PyCubed-Mini/avionics-mainboard/README.md

# avionics-motherboard
Main flight computer board for the PyCubed-Mini spacecraft
