PyCubed-Mini/avionics-mainboard/(threads)

Thread 1 (2022-02-22):

Replace camera FFC with 1.27mm stacking header

jbwillis, 2022-02-22:
Connection between camera and mainboard will be a 2x5 1.27mm stacking header [](https://www.digikey.com/en/products/detail/amphenol-icc-fci/20021121-00010C1LF/4243096)

- [x] Update footprint on Camera board
- [x] Update footprint on main board
- [x] ensure algnment between camera and main board is sufficient.
- [x] update 3D model to match board-board spacing between mainboard and camera board

Closed 2022-03-16.

Thread 2 (2022-02-22):

Load firmware onto current mainboard rev and run tests

jbwillis, 2022-02-22:
Follow instructions in `firmware` directory for loading firmware onto mainboard.

- [x] To power via USB, a jumper needs to be added to the RBF pin header.
- [x] Load firmware
- [x] See what tests already exist and run them. Ideas include I2C sniffer, neopixel flashing, reading IMU, connecting solar boards and reading sun sensor and solar controller data.

thetazero, 2022-02-23:
[Link](https://github.com/spacecraft-design-lab-2019/avionics-motherboard/tree/zac-updates/firmware) to said firmware directory for reference:

thetazero, 2022-02-24:
Updated the boards, and added instructions for how to do so [here](https://github.com/PyCubed-Mini/NewDocumentation/wiki/Circuit-Python#updating-the-pycubedmini-board).
Not sure how to connect the solar boards, that should probably be our next task.

Closed 2022-05-12.

Thread 4 (2022-02-23):

Change RBF pin to 1x6 header

jbwillis, 2022-02-23:
To allow space for the camera USB connector to be access through the Z board, change the RBF pin to a 1x6 header, and leave either pin 3 or 4 as no connect. We will fill the corresponding hole in the header with glue and cut the corresponding pin. This will act as a "key" to prevent accidental incorrect insertion.

Closed 2022-03-16.

Thread 8 (2022-06-02):

Test Burnwire circuit with PWM gate control, and switch BURN1 to a MCU pin with PWM support

NeilKhera, 2022-06-02:

Closed 2022-06-13.

Thread 9 (2022-06-13):

I2C 3 to solar boards

jbwillis, 2022-06-13:
Send I2C 3 to two solar boards to keep two boards per bus. This will allow us to use a different (easier to find) light sensor

Closed 2022-09-06.

Thread 11 (2022-07-06):

Reset button accessible from outside satellite

jbwillis, 2022-07-06:
To allow firmware updates without dissassembling, we need to make the reset button accessible from outside the satellite body.

My thought for how to do this is to put a right angle tactile switch on the mainboard and then have a small hole that a paperclip-wide pin can be pressed through to depress the switch.

NeilKhera, 2022-12-01:
Select a different right-angle reset button. The current one is kinda fragile

Closed 2023-03-16.

Thread 12 (2022-07-06):

Find new motor drivers

jbwillis, 2022-07-06:
Find new motor (magnetorquer) drivers, ideally ones that can be actuated via I2C.

Can separate the drivers onto different I2C busses, so same address won't be an issue.

NeilKhera, 2022-08-31:
No longer necessary since sufficient quantities of existing motor drivers were purchased.

Thread 15 (2022-08-03):

Replace X/Z solar connectors with CLP-105-02-F-DH-A

jbwillis, 2022-08-03:
should be easier to solder, plus they are mechanically compatible with the SFMH connectors currently on the mainboard, so no changes to the solar boards will be necessary.

Closed 2022-09-06.

Thread 17 (2022-08-12):

Change resistor divider to HI_POW rather than BATT_P

jbwillis, 2022-08-12:
To allow for testing with USB connected and the power select switch on VUSB, we need the mcu to measure the VUSB voltage rather than BATT_P.

Thread 18 (2022-08-12):

Add Real Time Clock

jbwillis, 2022-08-12:
A real time clock would enable us to keep track of time even when the mcu is off.
I don't believe we can have it powered during launch, so we will need to power it from the batteries (no separate battery for it).

Check the full PyCubed design to see if Max has already selected a RTC.

Closed 2022-09-06.

Thread 22 (2022-09-21):

Payload Interface

jbwillis, 2022-09-21:
- [x] Move SD card onto mainboard
- [ ] Remove all I2C bus protection circuits on mainboard
- [x] Route UART and 3V3 to Payload Board
- [x] Consider payload power enable to allow us to turn it on/off

Closed 2022-12-01.

Thread 26 (2022-12-01):

Add USB LiPo Charge Circuit?

NeilKhera, 2022-12-01:
Could be useful. The full-sized PyCubed board has this

jbwillis, 2022-12-01:
Yeah this could be nice. There are reasons not to though. Mostly so we can monitor the satellite without changing its power state.

Thread 28 (2023-01-13):

reduce board corners by 0.1mm on each side

jbwillis, 2023-01-13:
slight reduction in board outline (could even be less) to  avoid assembly interference.

Closed 2023-03-16.

Thread 30 (2023-03-26):

Connect IMU INT and RST lines to MCU

NeilKhera, 2023-03-26:
May be required for stable SPI operation. Further tests necessary

NeilKhera, 2023-04-26:
Fixed in Rev B3/02

Closed 2023-04-26.

Thread 33 (2023-04-26):

Replace reset button (again)

NeilKhera, 2023-04-26:

NeilKhera, 2023-04-26:
Replaced with Wurth 434331045822 in Rev B3/02

Closed 2023-04-26.
