PyCubed-Mini/avionics-mainboard/mainboard.kicad_pcb

## KiCad design mainboard.kicad_pcb (2023-06-20)

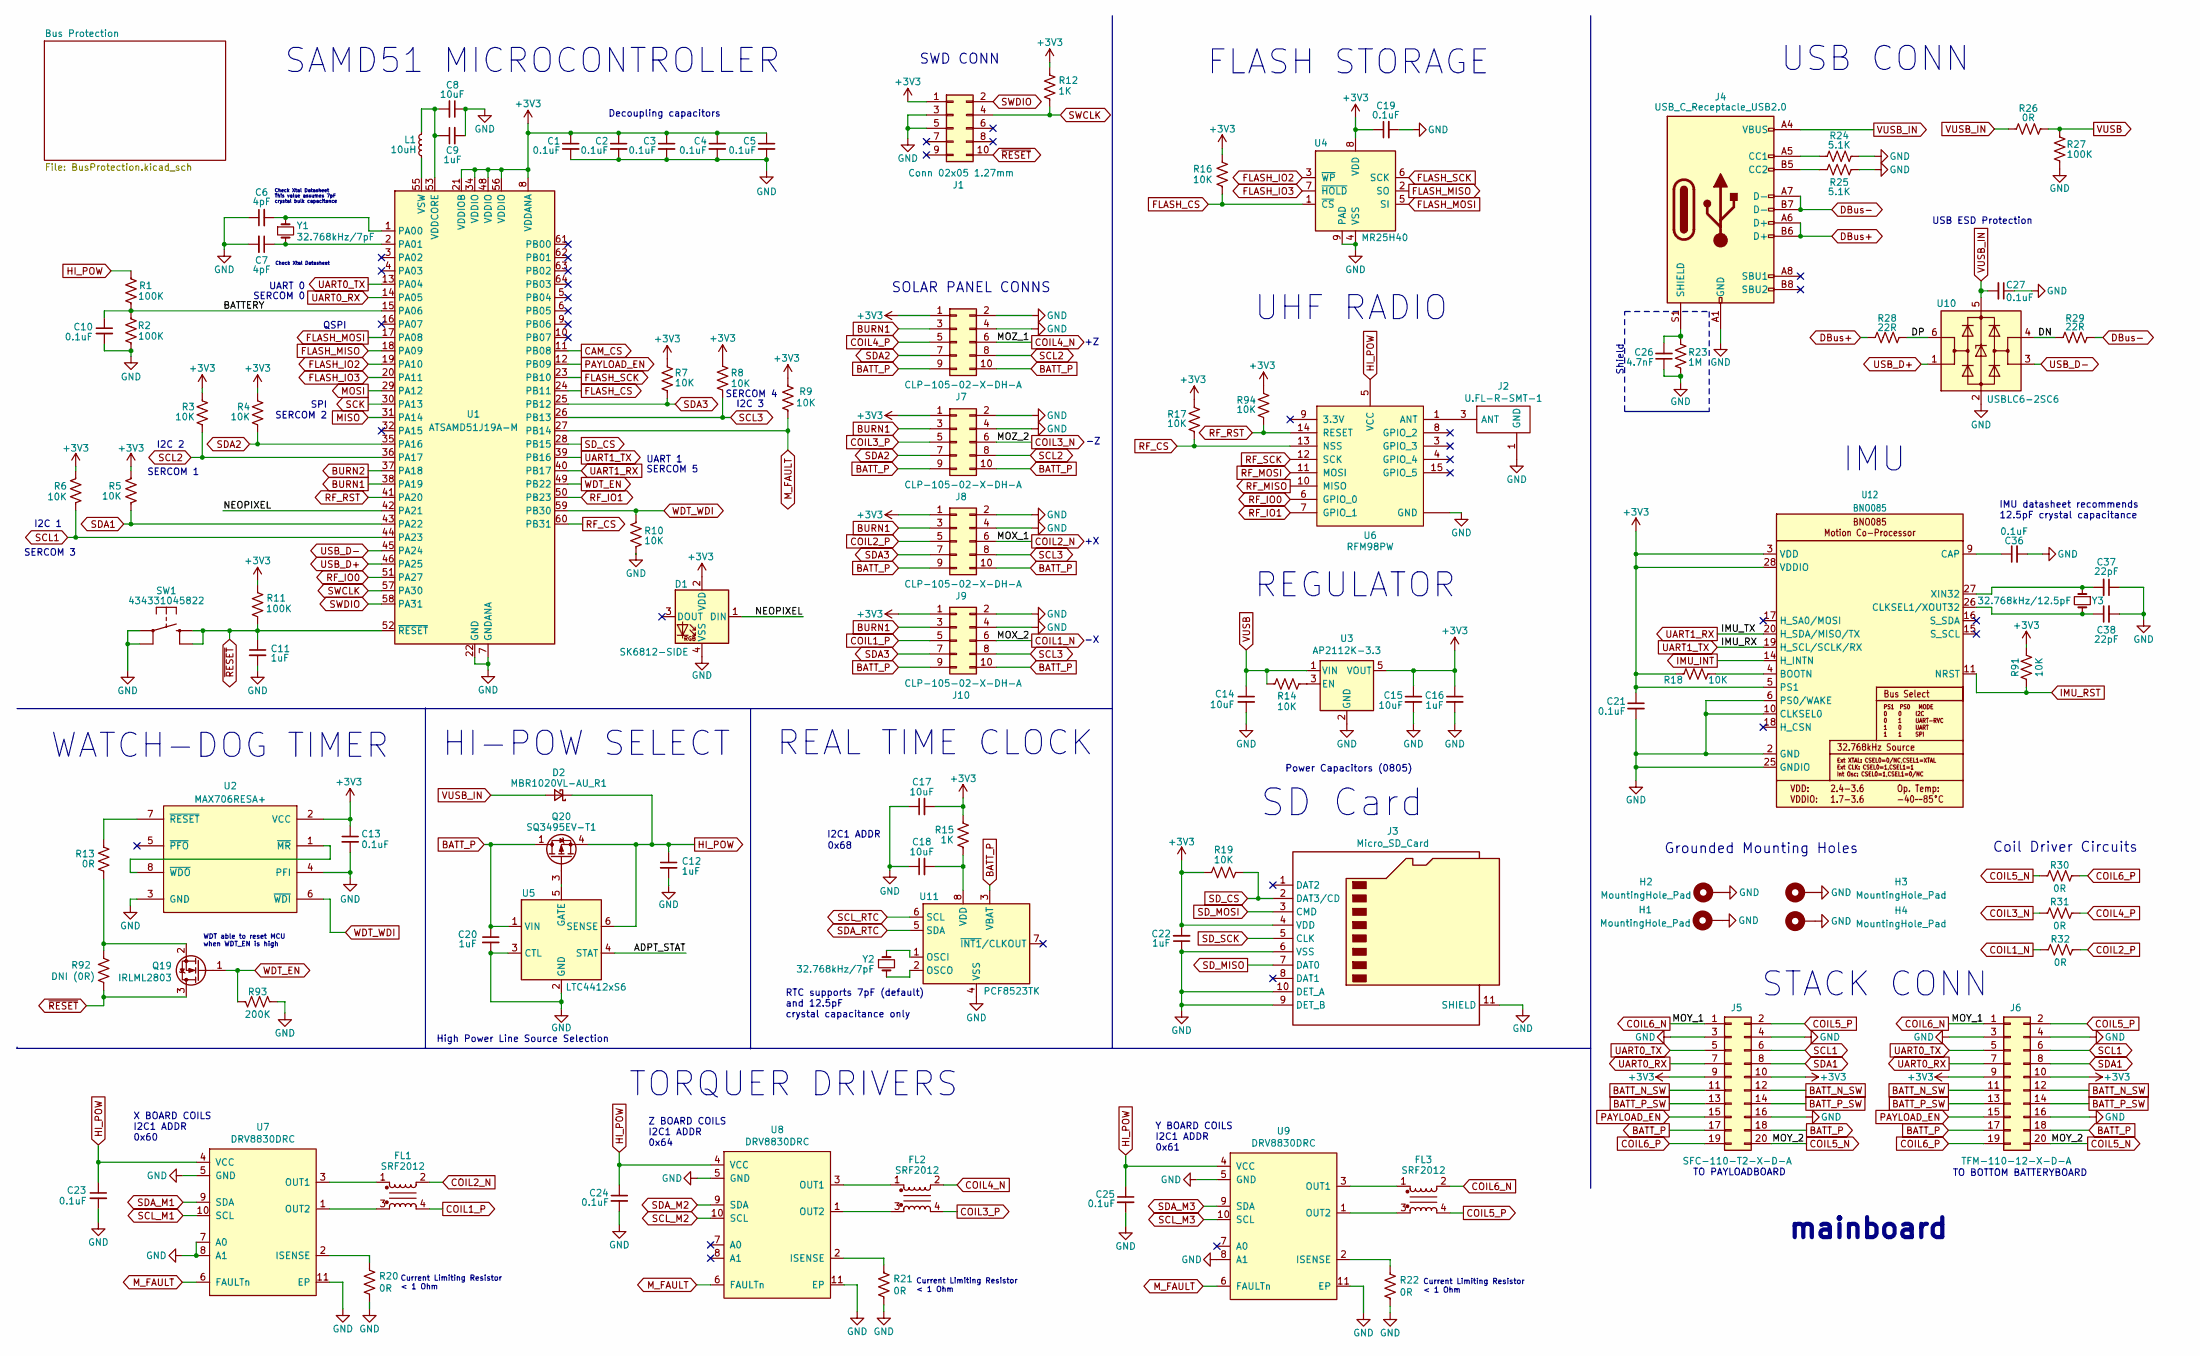
[picture p1: schematic mainboard.kicad_sch, PyCubed Mini]

Parts:
C1, C2, C3, C4, C5, C10, C13, C19, C21, C23, C24, C25, C27, C36: 0.1uF; C_0603_1608Metric
C6, C7: 4pF; C_0603_1608Metric
C8, C17, C18: 10uF; C_0603_1608Metric
C9, C11, C12, C20, C22: 1uF; C_0603_1608Metric
C14, C15: 10uF; C_0805_2012Metric
C16: 1uF; C_0805_2012Metric
C26: 4.7nF; C_0603_1608Metric
C37, C38: 22pF; C_0603_1608Metric
D1: SK6812-SIDE
D2: MBR1020VL-AU_R1; D_SOD-123F
FL1, FL2, FL3: SRF2012
H1, H2, H3, H4: MountingHole_Pad; MountingHole
J1: Conn 02x05 1.27mm; PinHeader_2x05_P1.27mm_Vertical_SMD
J2: U.FL-R-SMT-1; Manufacturer_Part_Number U.FL-R-SMT-1
J3: Micro_SD_Card; microSD_104031-0811
J4: USB_C_Receptacle_USB2.0; USB_C_Receptacle_HRO_TYPE-C-31-M-12
J5: SFC-110-T2-X-D-A; SAMTEC_SFC-110-T2-X-D-A
J6: TFM-110-12-X-D-A; SAMTEC_TFM-110-12-X-D-A
J7, J8, J9, J10: CLP-105-02-X-DH-A; SAMTEC_CLP-105-02-X-DH-A
L1: 10uH; L_0805_2012Metric
Q19: IRLML2803; SOT-23
Q20: SQ3495EV-T1; SOT-23-6
R1, R2, R11, R27: 100K; R_0603_1608Metric
R3, R4, R5, R6, R7, R8, R9, R10, R14, R16, R17, R18, R19, R91, R94: 10K; R_0603_1608Metric
R12, R15: 1K; R_0603_1608Metric
R13, R20, R21, R22, R26, R30, R31, R32: 0R; R_0603_1608Metric
R23: 1M; R_0603_1608Metric
R24, R25: 5.1K; R_0603_1608Metric
R28, R29: 22R; R_0603_1608Metric
R92: DNI (0R); R_0603_1608Metric
R93: 200K; R_0603_1608Metric
SW1: 434331045822; SMT_1045822_WRE
U1: ATSAMD51J19A-M; QFN-64-1EP_9x9mm_P0.5mm_EP4.7x4.7mm
U2: MAX706RESA+; SOIC-8_3.9x4.9mm_P1.27mm
U3: AP2112K-3.3; SOT-23-5
U4: MR25H40; MR25H40DF
U5: LTC4412xS6; TSOT-23-6
U6: RFM98PW
U7, U8, U9: DRV8830DRC; VSON-10
U10: USBLC6-2SC6; SOT-23-6
U11: PCF8523TK; HVSON-8-1EP_4x4mm_P0.8mm_EP2.2x3.1mm
U12: BNO085
Y1, Y2: 32.768kHz/7pF; Crystal_SMD_MicroCrystal_CC7V-T1A-2Pin_3.2x1.5mm
Y3: 32.768kHz/12.5pF; Crystal_SMD_MicroCrystal_CC7V-T1A-2Pin_3.2x1.5mm

Connections:
+3V3: C1.1, C2.1, C3.1, C4.1, C5.1, C13.1, C15.1, C16.1, C17.2, C19.1, C21.1, C22.2, D1.2 (VDD), J1.1, J3.4 (VDD), J5.9, J5.10, J6.9, J6.10, J7.1, J8.1, J9.1, J10.1, R3.2, R4.2, R5.2, R6.2, R7.2, R8.2, R9.1, R11.2, R12.2, R15.2, R16.1, R17.2, R18.2, R19.1, R91.2, R94.2, U1.8 (VDDANA), U1.21 (VDDIOB), U1.34 (VDDIO), U1.48 (VDDIO), U1.56 (VDDIO), U2.2 (VCC), U3.5 (VOUT), U4.8 (VDD), U12.3 (VDD), U12.5 (PS1), U12.28 (VDDIO); also elsewhere on the board
/ADPT_STAT: U5.4 (STAT)
/BATTERY: C10.1, R1.1, R2.2, U1.15 (PA06)
/DN: R29.2, U10.4 (I/O2)
/DP: R28.1, U10.6 (I/O1)
/NEOPIXEL: D1.1 (DIN), U1.42 (PA21)
BATT_N_SW: J5.11, J5.12, J6.11, J6.12
BATT_P: C20.1, J5.17, J5.18, J6.17, J6.18, J7.9, J7.10, J8.9, J8.10, J9.9, J9.10, J10.9, J10.10, Q20.1 (D), Q20.2 (D), Q20.5 (D), Q20.6 (D), U5.1 (VIN), U11.3 (VBAT)
BATT_P_SW: J5.13, J5.14, J6.13, J6.14
BURN1: J7.3, J8.3, J9.3, J10.3, U1.38 (PA19)
BURN2: U1.37 (PA18)
CAM_CS: U1.11 (PB08)
COIL1_N: J10.6, R32.1
COIL1_P: FL1.4, J10.5
COIL2_N: FL1.2, J9.6
COIL2_P: J9.5, R32.2
COIL3_N: J8.6, R31.1
COIL3_P: FL2.4, J8.5
COIL4_N: FL2.2, J7.6
COIL4_P: J7.5, R31.2
COIL5_N: J5.20, J6.20, R30.2
COIL5_P: FL3.4, J5.2, J6.2
COIL6_N: FL3.2, J5.1, J6.1
COIL6_P: J5.19, J6.19, R30.1
DBus+: J4.A6 (D+), J4.B6 (D+), R28.2
DBus-: J4.A7 (D-), J4.B7 (D-), R29.1
FLASH_CS: R16.2, U1.24 (PB11), U4.1 (~CS)
FLASH_IO2: U1.19 (PA10), U4.3 (~WP)
FLASH_IO3: U1.20 (PA11), U4.7 (~HOLD)
FLASH_MISO: U1.18 (PA09), U4.2 (SO)
FLASH_MOSI: U1.17 (PA08), U4.5 (SI)
FLASH_SCK: U1.23 (PB10), U4.6 (SCK)
GND: C1.2, C2.2, C3.2, C4.2, C5.2, C6.1, C7.2, C8.1, C9.2, C10.2, C11.2, C12.2, C13.2, C14.2, C15.2, C16.2, C17.1, C18.1, C19.2, C20.2, C21.2, C22.1, C23.2, C24.2, C25.2, C26.1, C27.1, C36.2, C37.1, C38.2, D1.4 (VSS), H1.1, H2.1, H3.1, H4.1, J1.3, J1.5, J2.1 (GND), J2.2, J3.6 (VSS), J3.9 (DET_B), J3.10 (DET_A), J3.11 (SHIELD), J4.A1 (GND), J4.A12 (GND), J4.B1 (GND), J4.B12 (GND), J5.3, J5.4, J5.16, J6.3, J6.4, J6.16, J7.2, J7.4, J8.2, J8.4, J9.2, J9.4, J10.2, J10.4, R2.1, R10.1, R20.1, R21.1, R22.1, R23.1, R24.2, R25.2, R27.2, R93.2, SW1.1, SW1.3 (P1), U1.7 (GNDANA), U1.22 (GND), U1.33 (GND), U1.47 (GND), U1.54 (GND), U1.65 (GND), U2.3 (GND), U2.4 (PFI), U3.2 (GND), U4.4 (VSS), U4.9 (PAD), U5.2 (GND), U5.3 (CTL), U6.2 (GND), U6.16 (GND), U6.17 (GND), U7.5 (GND), U7.7 (A0), U7.8 (A1), U7.11 (EP), U8.5 (GND), U8.11 (EP), U9.5 (GND), U9.8 (A1), U9.11 (EP), U10.2 (GND), U11.4 (VSS), U11.9 (VSS), U12.2 (GND), U12.6 (PS0/WAKE), U12.10 (CLKSEL0), U12.25 (GNDIO); also elsewhere on the board
HI_POW: C12.1, C23.1, C24.1, C25.1, D2.1 (K), Q20.4 (S), R1.2, U5.6 (SENSE), U6.5 (VCC), U7.4 (VCC), U8.4 (VCC), U9.4 (VCC)
IMU_INT: U12.14 (H_INTN)
IMU_RST: R91.1, U12.11 (NRST)
MISO: U1.31 (PA14); also elsewhere on the board
MOSI: U1.29 (PA12); also elsewhere on the board
M_FAULT: R9.2, U1.27 (PB14), U7.6 (FAULTn), U8.6 (FAULTn), U9.6 (FAULTn)
unnamed: J2.3 (ANT), U6.1 (ANT)
unnamed: J4.A5 (CC1), R24.1
unnamed: J4.B5 (CC2), R25.1
unnamed: C26.2, J4.S1 (SHIELD), R23.2
unnamed: Q19.2 (S), R13.1, R92.2
unnamed: Q20.3 (G), U5.5 (GATE)
unnamed: C6.2, U1.1 (PA00), Y1.1
unnamed: C7.1, U1.2 (PA01), Y1.2
unnamed: C8.2, C9.1, L1.1, U1.53 (VDDCORE)
unnamed: L1.2, U1.55 (VSW)
unnamed: U2.1 (~MR), U2.8 (~WDO)
unnamed: R13.2, U2.7 (~RESET)
unnamed: R14.2, U3.3 (EN)
unnamed: R20.2, U7.2 (ISENSE)
unnamed: FL1.1, U7.3 (OUT1)
unnamed: FL1.3, U7.1 (OUT2)
unnamed: R21.2, U8.2 (ISENSE)
unnamed: FL2.1, U8.3 (OUT1)
unnamed: FL2.3, U8.1 (OUT2)
unnamed: R22.2, U9.2 (ISENSE)
unnamed: FL3.1, U9.3 (OUT1)
unnamed: FL3.3, U9.1 (OUT2)
unnamed: U11.1 (OSCI), Y2.1
unnamed: U11.2 (OSCO), Y2.2
unnamed: C18.2, R15.1, U11.8 (VDD)
unnamed: R18.1, U12.4 (BOOTN)
unnamed: C36.1, U12.9 (CAP)
unnamed: C38.1, U12.26 (CLKSEL1/XOUT32), Y3.2
unnamed: C37.2, U12.27 (XIN32), Y3.1
PAYLOAD_EN: J5.15, J6.15, U1.12 (PB09)
RF_CS: R17.1, U1.60 (PB31), U6.13 (NSS); also elsewhere on the board
RF_IO0: U1.51 (PA27), U6.6 (GPIO_0)
RF_IO1: U1.50 (PB23), U6.7 (GPIO_1)
RF_MISO: U6.10 (MISO); also elsewhere on the board
RF_MOSI: U6.11 (MOSI); also elsewhere on the board
RF_RST: R94.1, U1.41 (PA20), U6.14 (RESET)
RF_SCK: U6.12 (SCK); also elsewhere on the board
SCK: U1.30 (PA13); also elsewhere on the board
SCL1: J5.6, J6.6, R6.1, U1.44 (PA23); also elsewhere on the board
SCL2: J7.8, J8.8, R3.1, U1.36 (PA17)
SCL3: J9.8, J10.8, R8.1, U1.26 (PB13)
SCL_M1: U7.10 (SCL); also elsewhere on the board
SCL_M2: U8.10 (SCL); also elsewhere on the board
SCL_M3: U9.10 (SCL); also elsewhere on the board
SCL_RTC: U11.6 (SCL); also elsewhere on the board
SDA1: J5.8, J6.8, R5.1, U1.43 (PA22); also elsewhere on the board
SDA2: J7.7, J8.7, R4.1, U1.35 (PA16)
SDA3: J9.7, J10.7, R7.1, U1.25 (PB12)
SDA_M1: U7.9 (SDA); also elsewhere on the board
SDA_M2: U8.9 (SDA); also elsewhere on the board
SDA_M3: U9.9 (SDA); also elsewhere on the board
SDA_RTC: U11.5 (SDA); also elsewhere on the board
SD_CS: J3.2 (DAT3/CD), R19.2, U1.28 (PB15); also elsewhere on the board
SD_MISO: J3.7 (DAT0); also elsewhere on the board
SD_MOSI: J3.3 (CMD); also elsewhere on the board
SD_SCK: J3.5 (CLK); also elsewhere on the board
SWCLK: J1.4, R12.1, U1.57 (PA30)
SWDIO: J1.2, U1.58 (PA31)
UART0_RX: J5.7, J6.7, U1.14 (PA05)
UART0_TX: J5.5, J6.5, U1.13 (PA04)
UART1_RX: U1.40 (PB17), U12.20 (H_SDA/MISO/TX)
UART1_TX: U1.39 (PB16), U12.19 (H_SCL/SCLK/RX)
USB_D+: U1.46 (PA25), U10.1 (I/O1)
USB_D-: U1.45 (PA24), U10.3 (I/O2)
VUSB: C14.1, R14.1, R26.2, R27.1, U3.1 (VIN)
VUSB_IN: C27.2, D2.2 (A), J4.A4 (VBUS), J4.A9 (VBUS), J4.B4 (VBUS), J4.B9 (VBUS), R26.1, U10.5 (VBUS)
WDT_EN: Q19.1 (G), R93.1, U1.49 (PB22)
WDT_WDI: R10.2, U1.59 (PB30), U2.6 (~WDI)
~RESET: C11.1, J1.10, Q19.3 (D), R11.1, R92.1, SW1.2 (S), SW1.4 (S1), U1.52 (~RESET)

Notes on the sheet:
High Power Line Source Selection
X BOARD COILS I2C1 ADDR 0x60
SERCOM 0
WDT able to reset MCU when WDT_EN is high
Current Limiting Resistor < 1 Ohm
mainboard
0x68
SAMD51 MICROCONTROLLER
FLASH STORAGE
UART 1
USB ESD Protection
REGULATOR
UART 0
SOLAR PANEL CONNS
SPI
I2C 3
Check Xtal Datasheet
IMU datasheet recommends 12.5pF crystal capacitance
TO BOTTOM BATTERYBOARD
TORQUER DRIVERS
WATCH-DOG TIMER
SWD CONN
SERCOM 1
Coil Driver Circuits
STACK CONN
Shield
SERCOM 5
Decoupling capacitors
I2C 2
SERCOM 3
Z BOARD COILS I2C1 ADDR 0x64
IMU
UHF RADIO
SERCOM 2
Check Xtal Datasheet This value assumes 7pF crystal bulk capacitance
I2C 1
SERCOM 4
Grounded Mounting Holes
USB CONN
SD Card
HI-POW SELECT
REAL TIME CLOCK
Y BOARD COILS I2C1 ADDR 0x61
Power Capacitors (0805)
QSPI
TO PAYLOADBOARD
I2C1 ADDR
RTC supports 7pF (default) and 12.5pF crystal capacitance only

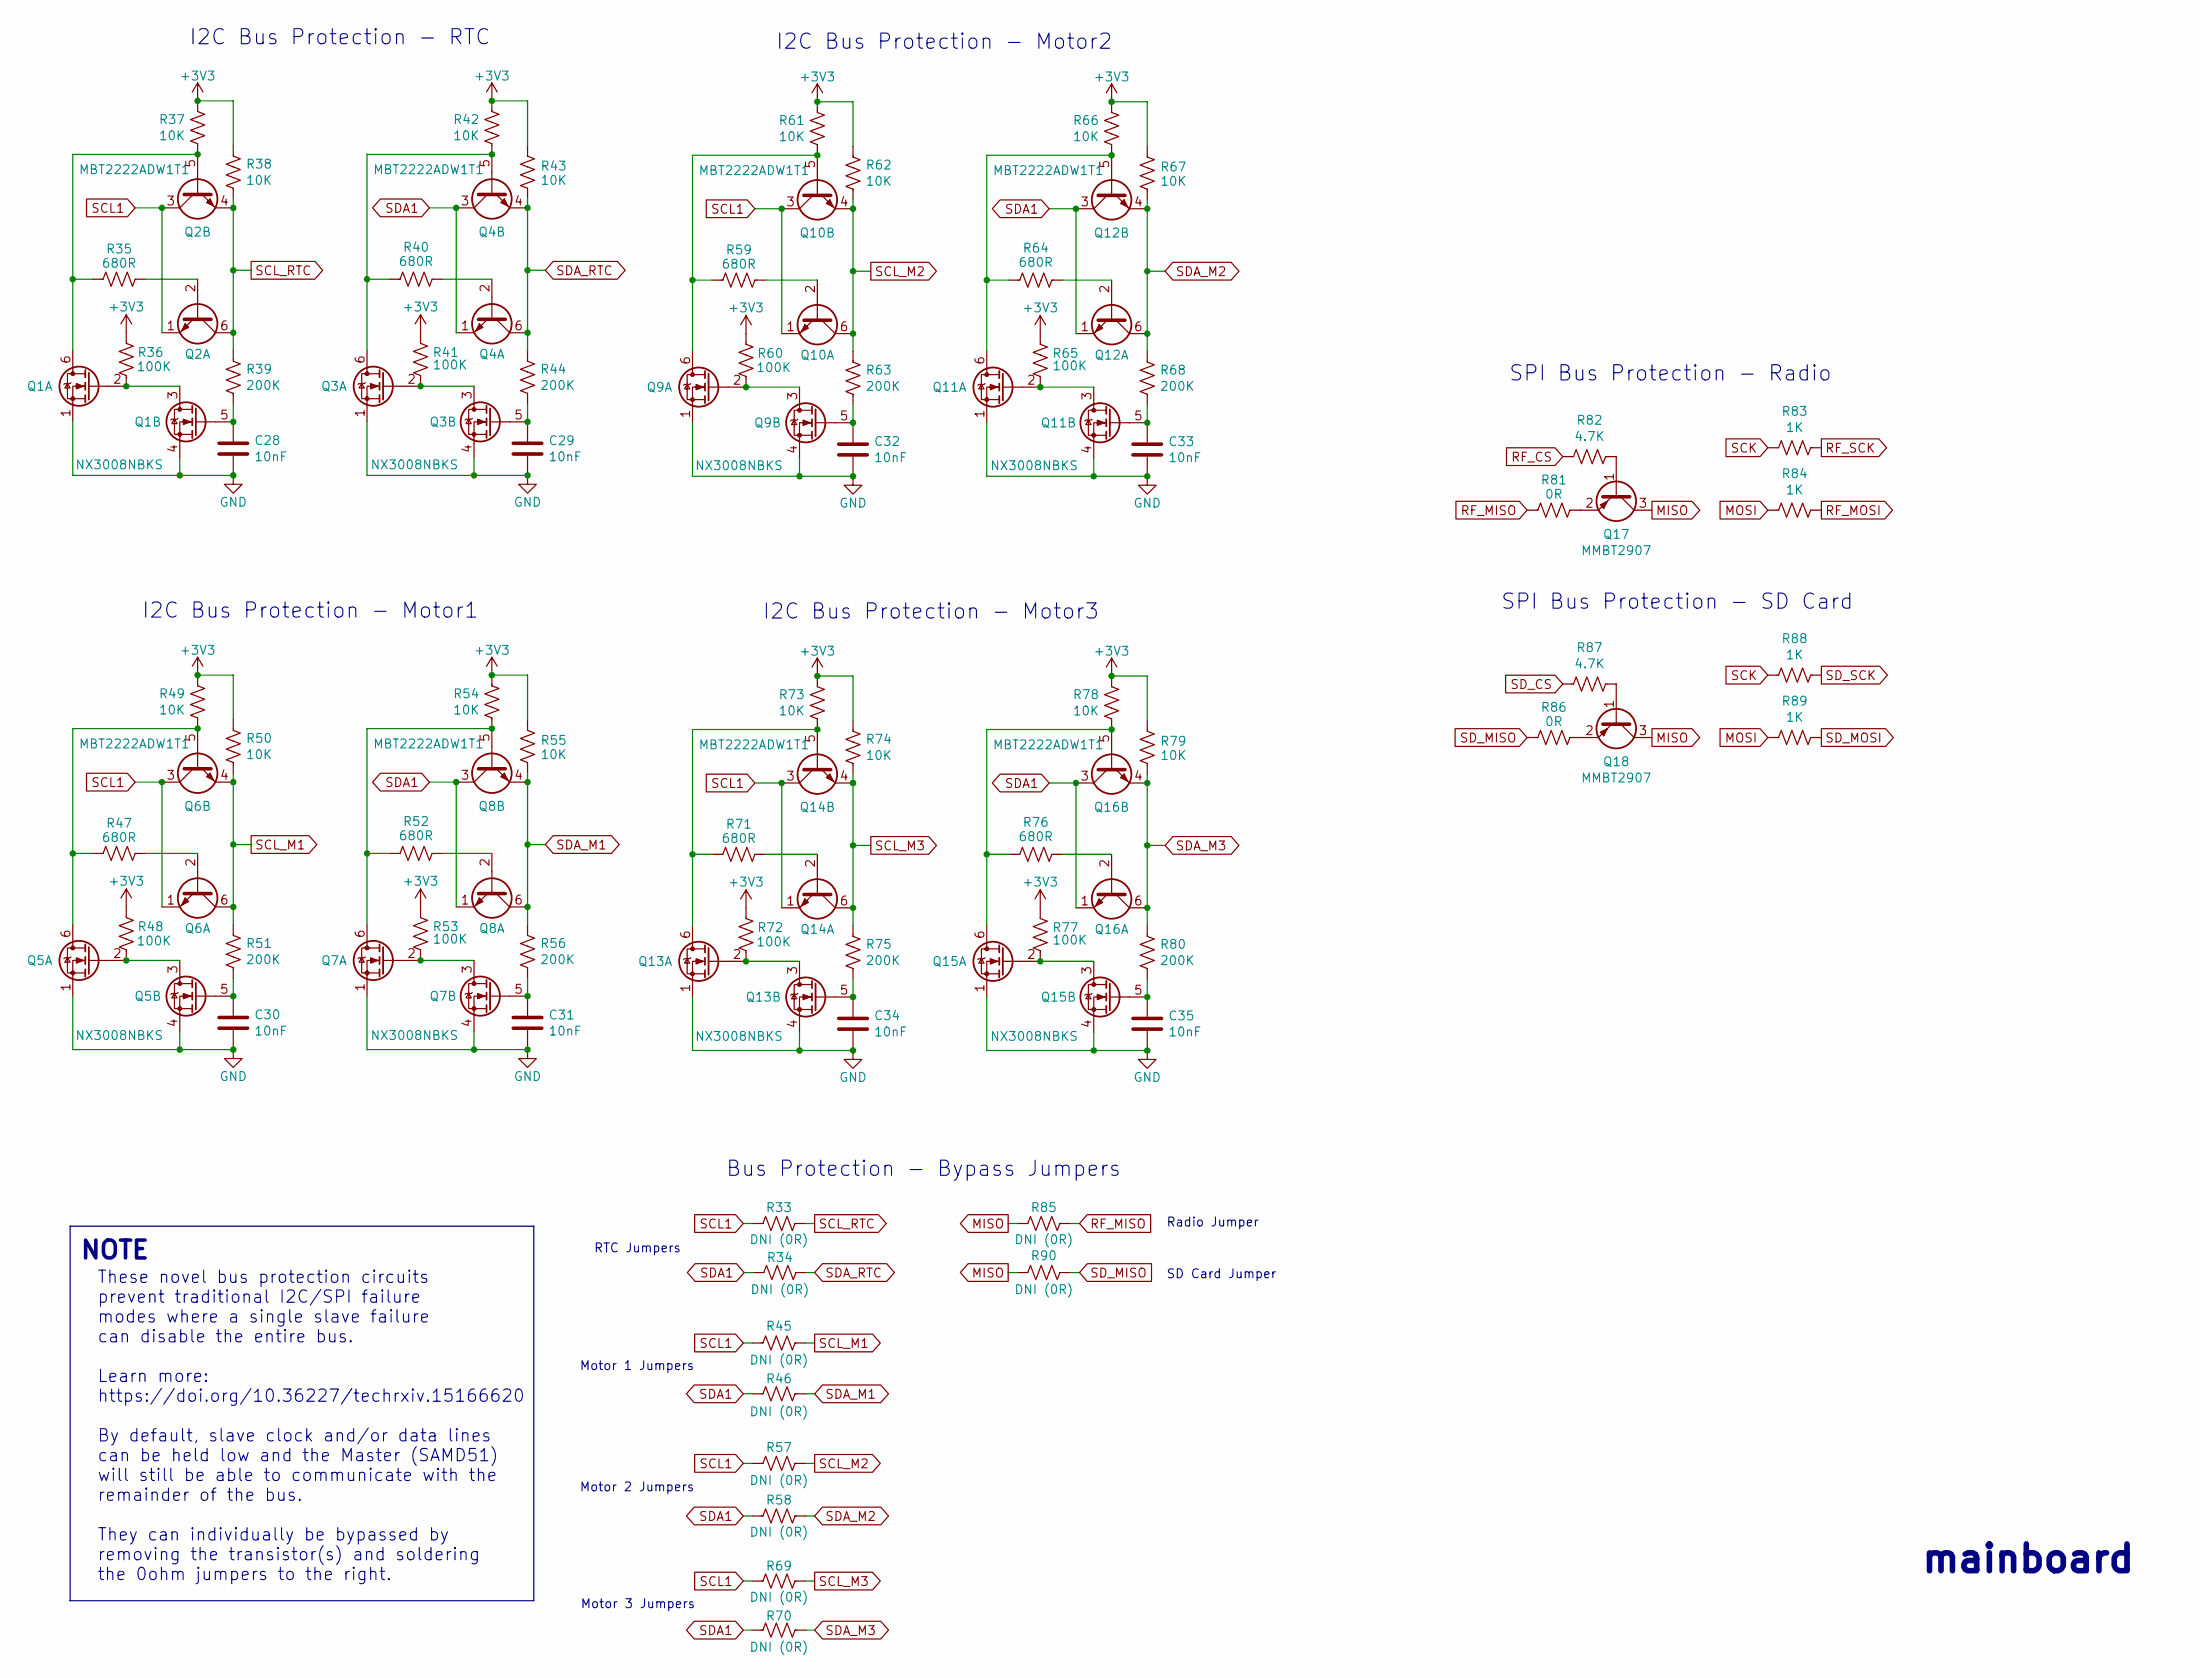
[picture p2: schematic BusProtection.kicad_sch, PyCubed Mini]

Parts:
C28, C29, C30, C31, C32, C33, C34, C35: 10nF; C_0603_1608Metric
Q1, Q3, Q5, Q7, Q9, Q11, Q13, Q15: NX3008NBKS; SOT-363_SC-70-6; Manufacturer_Part_Number NX3008NBKS
Q2, Q4, Q6, Q8, Q10, Q12, Q14, Q16: MBT2222ADW1T1; SOT-363_SC-70-6; Manufacturer_Part_Number MBT2222ADW1T1G
Q17, Q18: MMBT2907; SOT-23; Manufacturer_Part_Number MMBT2907ALT1G
R33, R34, R45, R46, R57, R58, R69, R70, R85, R90: DNI (0R); R_0603_1608Metric
R35, R40, R47, R52, R59, R64, R71, R76: 680R; R_0603_1608Metric
R36, R41, R48, R53, R60, R65, R72, R77: 100K; R_0603_1608Metric
R37, R38, R42, R43, R49, R50, R54, R55, R61, R62, R66, R67, R73, R74, R78, R79: 10K; R_0603_1608Metric
R39, R44, R51, R56, R63, R68, R75, R80: 200K; R_0603_1608Metric
R81, R86: 0R; R_0603_1608Metric
R82, R87: 4.7K; R_0603_1608Metric
R83, R84, R88, R89: 1K; R_0603_1608Metric

Connections:
+3V3: R36.1, R37.1, R38.1, R41.1, R42.1, R43.1, R48.1, R49.1, R50.1, R53.1, R54.1, R55.1, R60.1, R61.1, R62.1, R65.1, R66.1, R67.1, R72.1, R73.1, R74.1, R77.1, R78.1, R79.1; also elsewhere on the board
GND: C28.2, C29.2, C30.2, C31.2, C32.2, C33.2, C34.2, C35.2, Q1.1 (S2), Q1.4 (S1), Q3.1 (S2), Q3.4 (S1), Q5.1 (S2), Q5.4 (S1), Q7.1 (S2), Q7.4 (S1), Q9.1 (S2), Q9.4 (S1), Q11.1 (S2), Q11.4 (S1), Q13.1 (S2), Q13.4 (S1), Q15.1 (S2), Q15.4 (S1); also elsewhere on the board
MISO: Q17.3 (C), Q18.3 (C), R85.2, R90.2; also elsewhere on the board
MOSI: R84.2, R89.2; also elsewhere on the board
unnamed: Q1.6 (D1), Q2.5 (B2), R35.2, R37.2
unnamed: Q1.2 (G2), Q1.3 (D2), R36.2
unnamed: C28.1, Q1.5 (G1), R39.2
unnamed: Q2.2 (B1), R35.1
unnamed: Q3.6 (D1), Q4.5 (B2), R40.2, R42.2
unnamed: Q3.2 (G2), Q3.3 (D2), R41.2
unnamed: C29.1, Q3.5 (G1), R44.2
unnamed: Q4.2 (B1), R40.1
unnamed: Q5.6 (D1), Q6.5 (B2), R47.2, R49.2
unnamed: Q5.2 (G2), Q5.3 (D2), R48.2
unnamed: C30.1, Q5.5 (G1), R51.2
unnamed: Q6.2 (B1), R47.1
unnamed: Q7.6 (D1), Q8.5 (B2), R52.2, R54.2
unnamed: Q7.2 (G2), Q7.3 (D2), R53.2
unnamed: C31.1, Q7.5 (G1), R56.2
unnamed: Q8.2 (B1), R52.1
unnamed: Q9.2 (G2), Q9.3 (D2), R60.2
unnamed: C32.1, Q9.5 (G1), R63.2
unnamed: Q10.2 (B1), R59.1
unnamed: Q9.6 (D1), Q10.5 (B2), R59.2, R61.2
unnamed: Q11.6 (D1), Q12.5 (B2), R64.2, R66.2
unnamed: Q11.2 (G2), Q11.3 (D2), R65.2
unnamed: C33.1, Q11.5 (G1), R68.2
unnamed: Q12.2 (B1), R64.1
unnamed: Q13.6 (D1), Q14.5 (B2), R71.2, R73.2
unnamed: Q13.2 (G2), Q13.3 (D2), R72.2
unnamed: C34.1, Q13.5 (G1), R75.2
unnamed: Q14.2 (B1), R71.1
unnamed: Q15.6 (D1), Q16.5 (B2), R76.2, R78.2
unnamed: Q15.2 (G2), Q15.3 (D2), R77.2
unnamed: C35.1, Q15.5 (G1), R80.2
unnamed: Q16.2 (B1), R76.1
unnamed: Q17.1 (B), R82.1
unnamed: Q17.2 (E), R81.1
unnamed: Q18.1 (B), R87.1
unnamed: Q18.2 (E), R86.1
RF_CS: R82.2; also elsewhere on the board
RF_MISO: R81.2, R85.1; also elsewhere on the board
RF_MOSI: R84.1; also elsewhere on the board
RF_SCK: R83.1; also elsewhere on the board
SCK: R83.2, R88.2; also elsewhere on the board
SCL1: Q2.1 (E1), Q2.3 (C2), Q6.1 (E1), Q6.3 (C2), Q10.1 (E1), Q10.3 (C2), Q14.1 (E1), Q14.3 (C2), R33.2, R45.2, R57.2, R69.2; also elsewhere on the board
SCL_M1: Q6.4 (E2), Q6.6 (C1), R45.1, R50.2, R51.1; also elsewhere on the board
SCL_M2: Q10.4 (E2), Q10.6 (C1), R57.1, R62.2, R63.1; also elsewhere on the board
SCL_M3: Q14.4 (E2), Q14.6 (C1), R69.1, R74.2, R75.1; also elsewhere on the board
SCL_RTC: Q2.4 (E2), Q2.6 (C1), R33.1, R38.2, R39.1; also elsewhere on the board
SDA1: Q4.1 (E1), Q4.3 (C2), Q8.1 (E1), Q8.3 (C2), Q12.1 (E1), Q12.3 (C2), Q16.1 (E1), Q16.3 (C2), R34.2, R46.2, R58.2, R70.2; also elsewhere on the board
SDA_M1: Q8.4 (E2), Q8.6 (C1), R46.1, R55.2, R56.1; also elsewhere on the board
SDA_M2: Q12.4 (E2), Q12.6 (C1), R58.1, R67.2, R68.1; also elsewhere on the board
SDA_M3: Q16.4 (E2), Q16.6 (C1), R70.1, R79.2, R80.1; also elsewhere on the board
SDA_RTC: Q4.4 (E2), Q4.6 (C1), R34.1, R43.2, R44.1; also elsewhere on the board
SD_CS: R87.2; also elsewhere on the board
SD_MISO: R86.2, R90.1; also elsewhere on the board
SD_MOSI: R89.1; also elsewhere on the board
SD_SCK: R88.1; also elsewhere on the board

Notes on the sheet:
Motor 3 Jumpers
I2C Bus Protection - RTC
I2C Bus Protection - Motor3
I2C Bus Protection - Motor2
Motor 1 Jumpers
NOTE
SPI Bus Protection - SD Card
Bus Protection - Bypass Jumpers
I2C Bus Protection - Motor1
RTC Jumpers
Radio Jumper
mainboard
SPI Bus Protection - Radio
SD Card Jumper
Motor 2 Jumpers
These novel bus protection circuits prevent traditional I2C/SPI failure modes where a single slave failure can disable the entire bus. Learn more: https://doi.org/10.36227/techrxiv.15166620 By default, slave clock and/or data lines can be held low and the Master (SAMD51) will still be able to commu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

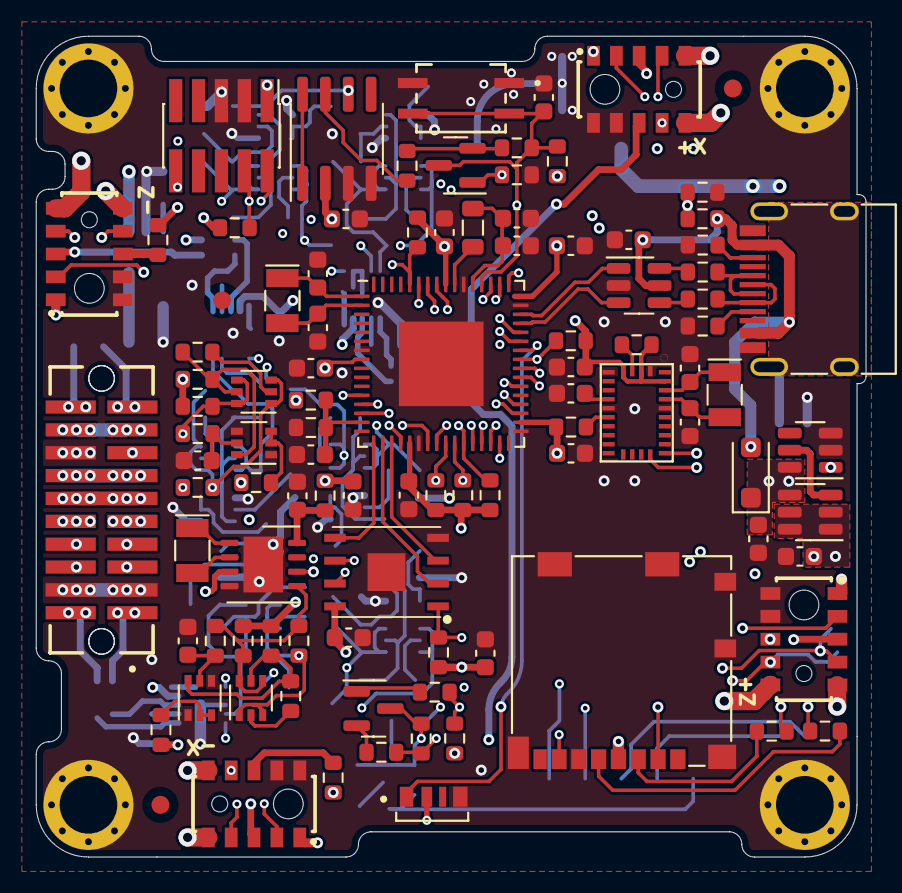
[picture p3: board mainboard.kicad_pcb from above]

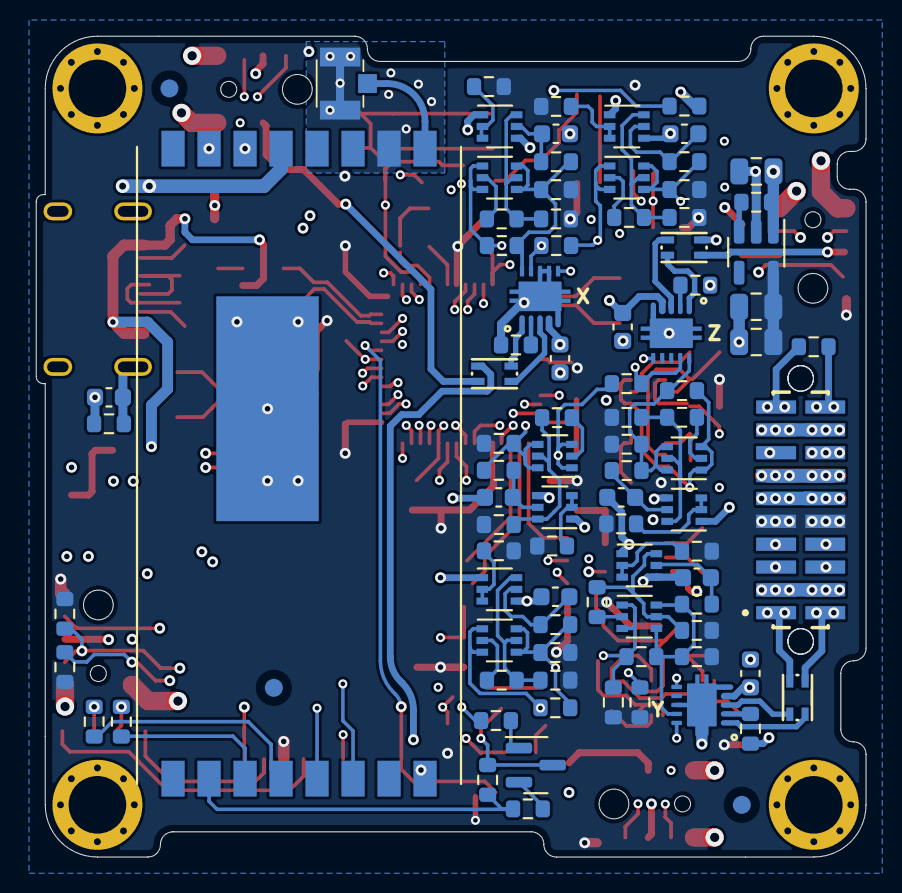
[picture p4: board mainboard.kicad_pcb from below]

Board: 4 copper layers, 46.1 x 45.6 mm, 189 parts (88 on the bottom side), 140 nets.

Other parts of the board:
Ref**: Val**; pycubed_mini_half
