PyCubed-Mini/avionics-mainboard/(commit log)

2019-10-03 adding sprite reference design
    [output.sprite_panel-B_Cu.gbr, output.sprite_panel-B_Mask.gbr, output.sprite_panel-B_Paste.gbr, output.sprite_panel-B_SilkS.gbr, output.sprite_panel-Edge_Cuts.gbr, output.sprite_panel-F_Cu.gbr, output.sprite_panel-F_Mask.gbr, output.sprite_panel-F_Paste.gbr]
2019-10-14 First take at schematic and PCB Design
    Includes SAMD51 MCU, Semtech 1280 UHF module, Semtech 1278 LoRa Module, and a micro SD card module
2019-10-16 Motherboard
    Updated with SAMD51, LoRA and UHF modules, IMU, and MicroSD card module
    [Motherboard.kicad_pcb, Motherboard.sch]
2019-10-16 cleaning up reference design
    [output.sprite_panel-B_Cu.gbr, output.sprite_panel-B_Mask.gbr, output.sprite_panel-B_Paste.gbr, output.sprite_panel-B_SilkS.gbr, output.sprite_panel-Edge_Cuts.gbr, output.sprite_panel-F_Cu.gbr, output.sprite_panel-F_Mask.gbr, output.sprite_panel-F_Paste.gbr]
2019-10-21 Updated Avionics Motherboard Based on Sprite Design
    Changes from Sprite design:
    - Added two radio modules and corresponding antennae
    - Disconnected regulator from solar cells / battery power
    - Added BMX 160 IMU (original Sprite IMU left on board for discussion)
    - Added flat flex connector (24 pins)
    [digikeyorder.xlsx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]
2019-10-22 Add files via upload
    commiting changes again
    [mainboard.kicad_pcb, mainboard.sch, spriteSAMD.kicad_pcb, spriteSAMD.sch]
2019-10-22 adding second I2C bus and fixing SPI pins
    [mainboard.sch]
2019-10-22 adding pull-up resistors to I2C
    [mainboard.sch]
2019-10-22 removing confusing files
    [spriteSAMD.kicad_pcb]
2019-10-22 experiment for schematic "snapshot"
2019-10-22 adding quick schematic snapshot
2019-10-22 quick step export for CAD
2019-10-23 updated PCB layout
    [mainboard.kicad_pcb, mainboard.sch, spriteSAMD.kicad_pcb]
2019-10-23 updated H-bridge nets on schematic
    [mainboard.sch]
2019-10-23 updated H-bridge footprints with footprints from component search engine
    [mainboard.sch]
2019-10-23 updated top layer PCB layout
    [mainboard.kicad_pcb]
2019-10-23 updated placement of H-bridges, flat flex connector, and additional wirings
    [mainboard.kicad_pcb]
2019-10-23 updated wiring on top layer, added CS_IMU net
    [mainboard.kicad_pcb, mainboard.sch]
2019-10-23 updating board outline to tentative design per @ellised discussion
    [mainboard.kicad_pcb, spriteSAMD.kicad_pcb]
2019-10-23 updated wiring on top layer, added CS_IMU connections
    [mainboard.kicad_pcb]
2019-10-23 updated camera connector and connected to MCU and flat flex connector
    [mainboard.kicad_pcb, mainboard.sch]
2019-10-23 added vias to flat flex connector, added traces to comm protocols off of MCU
    [mainboard.kicad_pcb]
2019-10-23 added WDT_WDI net to MCU, connected C2, C5, and L1 to MCU
    [mainboard.kicad_pcb, mainboard.sch]
2019-10-23 added traces for J29, J28, J30
    [mainboard.kicad_pcb]
2019-10-23 deleted accidental bottom traces on bottom of board
    [mainboard.kicad_pcb]
2019-10-23 updated position of UHF on bottom of board to not overlap MCU
    [mainboard.kicad_pcb]
2019-10-23 added watchdog timer footprint to PCB layout
    [mainboard.kicad_pcb]
2019-10-23 added comm vias and traces to LoRa radio module on top layer
    [mainboard.kicad_pcb]
2019-10-23 added SCL2 and SDA2 traces between MCU and flat flex connector
    [mainboard.kicad_pcb, mainboard.sch]
2019-10-23 updated location of USB and watchdog timer on top layer, connected watchdog timer to R3 and reset nest on MCU
    [mainboard.kicad_pcb]
2019-10-23 updated board outline to match re-location of USB
    [mainboard.kicad_pcb]
2019-10-23 updated H-bridge positions on bottom layer
    [mainboard.kicad_pcb]
2019-10-23 updated H-bridge positions traces with capacitors on bottom layer
    [mainboard.kicad_pcb]
2019-10-23 updated traces for UHF and SD card on bottom layer
    [mainboard.kicad_pcb]
2019-10-23 updated bottom layer traces
    [mainboard.kicad_pcb]
2019-10-24 put top layer back in after accidentally deleting it....
    [mainboard.kicad_pcb]
2019-10-24 updated H-bridge voltage nests on schematic, updated traces on PCB for H-bridges to flat flex connector and for watchdog timer
    [mainboard.kicad_pcb, mainboard.sch]
2019-10-24 finished final touches for motherboard first draft
    [mainboard.kicad_pcb]
2019-10-24 placement rework with 2019-10-23 mechanical updates
    [mainboard.kicad_pcb, mainboard.sch]
2019-10-24 mainboard files
    [mainboard.kicad_pcb, mainboard.sch]
2019-10-24 added routing for flex connectors to hbridge
    [mainboard.kicad_pcb, mainboard.sch]
2019-10-25 very minor cleanup
    [mainboard.kicad_pcb]
2019-10-26 fab files for mainboard
    [mainboard-B_Mask.gbs, mainboard-B_Paste.gbp, mainboard-B_SilkS.gbo, mainboard-Bottom.gbl, mainboard-Edge_Cuts.gm1, mainboard-F_Mask.gts, mainboard-F_Paste.gtp, mainboard-F_SilkS.gto]
2019-10-26 Added RF test board
    [spriteSAMD.kicad_pcb, spriteSAMD.sch]
2019-10-26 fab output for JLCPCB
    [mainboard-B_Mask.gbr, mainboard-B_Paste.gbr, mainboard-B_SilkS.gbr, mainboard-Bottom.gbr, mainboard-Edge_Cuts.gbr, mainboard-F_Mask.gbr, mainboard-F_Paste.gbr, mainboard-F_SilkS.gbr]
2019-10-26 interactive BOM
2019-10-30 Add files via upload
    imported .dxf board outline from mechanical
    [mainboard.kicad_pcb]
2019-10-31 modified board outline based on update from mechanical, including USB slot
    [mainboard.kicad_pcb]
2019-11-12 Fixed Mistake in RF Test Board
    [spriteSAMD.kicad_pcb, spriteSAMD.sch]
2019-11-13 created folder to dump kicad antennae breakout
2019-11-13 added antennae breakout board files
    [ant breakout.kicad_pcb, ant breakout.sch]
2019-11-13 Updated files
    [ant breakout.kicad_pcb]
2019-11-14 updated footprint
    [ant breakout.kicad_pcb, ant breakout.sch]
2019-11-15 Dxf file of the internal board cutout.
    [11-14-19 Internal boards.dxf]
2019-11-19 associated pin names with variables
2019-11-19 updated edge cuts to match updated mechanical .dxf file (to allow flat flex connectors to travel around board edge)
    [mainboard.kicad_pcb, mainboard.sch]
2019-11-19 updated bottom layer edge mapping to edge cuts, deleted most vias/traces and started reworking component placement.
2019-11-20 Updated component placement on top and bottom faces (no traces)
    [mainboard.kicad_pcb]
2019-11-20 updated layout with new camera connector placement, more traces, removed mounting holes
    [mainboard.kicad_pcb, mainboard.sch]
2019-11-20 updated footprints for U.FL connectors, more traces added
    [mainboard.kicad_pcb, mainboard.sch]
2019-11-20 updated KiCAD libraries with new footprints from component search engine
2019-11-20 updated camera placement to avoid vertical pulling
    [mainboard.kicad_pcb]
2019-11-20 updated traces
    [mainboard.kicad_pcb]
2019-11-21 adjusted ordering in flat flex connector to avoid ratsnest crossings for Hbridges, added camera traces
    [mainboard.kicad_pcb, mainboard.sch]
2019-11-21 updated pycubed board edge cuts, updated top layer copper edges, shifted USB card and flat flex connector (still need to shift camera connector)
    [mainboard-B_Mask.gbr, mainboard-B_Paste.gbr, mainboard-B_SilkS.gbr, mainboard-Bottom.gbr, mainboard-Edge_Cuts.gbr, mainboard-F_Mask.gbr, mainboard-F_Paste.gbr, mainboard-F_SilkS.gbr]
2020-01-01 adding v01 + repo overhaul
    [ant breakout.kicad_pcb, ant breakout.sch, digikeyorder.xlsx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]
2020-01-30 adding default libraries, examples, and PIN-NAMES.txt
2020-01-31 fixed CP build files to accmodate recent .ld implimentation changes.
    [mpconfigboard.h]
2020-02-18 added git ignore for kicad backup files
2020-02-18 Updated magnetorquer driver and fixed some PCB DRC issues
    [mainboard.kicad_pcb, mainboard.sch]
2020-02-20 updated 3d footprint paths and generated new step file
    [mainboard.kicad_pcb]
2020-03-01 added fiducials, regenerated 3d model and gerbers
    [11-14-19 Internal boards.dxf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]
2020-08-11 schematic work
    [mainboard.sch]
2020-08-11 finished schematic changes
    [mainboard.sch]
2020-08-20 updated footprints
    [mainboard.kicad_pcb, mainboard.sch]
2020-08-21 power coil drivers directly from battery
    [mainboard.kicad_pcb, mainboard.sch]
2020-08-21 cleaned off layout
    [mainboard.kicad_pcb]
2020-08-24 beginning layout
    [mainboard.kicad_pcb, mainboard.sch]
2020-08-24 some routing
    [mainboard.kicad_pcb]
2020-08-25 lots of routing
    [mainboard.kicad_pcb, mainboard.sch]
2020-08-25 layout minus dosimeter
    [mainboard.kicad_pcb, mainboard.sch]
2020-08-25 initial layout done
    [mainboard.kicad_pcb]
2020-08-25 RGB LED
    [mainboard.kicad_pcb, mainboard.sch]
2020-08-26 changed LDO and added RBF header
    [mainboard.kicad_pcb, mainboard.sch]
2020-08-26 BATT_P cleanup. starting dosimeter tweaks
    [mainboard.kicad_pcb, mainboard.sch]
2020-08-26 fit-checked with CAD
    [mainboard.kicad_pcb, mainboard.sch]
2020-08-26 removed dosimeter & roughed in new RBF header
    [mainboard.kicad_pcb, mainboard.sch]
2020-08-26 roughed-in SD card
    [mainboard.kicad_pcb, mainboard.sch]
2020-08-26 added xtal
    [mainboard.kicad_pcb, mainboard.sch]
2020-08-26 silkscreen placed
    [mainboard.kicad_pcb]
2020-08-26 updating CAD models
    [mainboard.kicad_pcb]
2020-08-26 pretty BOM and schematic pdf
    [mainboard.sch]
2020-08-26 ran DRC & added pullups
    [mainboard.kicad_pcb, mainboard.sch]
2020-08-26 manufacturing files + JLCPCB order placed
    [mainboard-B.Mask.gbr, mainboard-B.Paste.gbr, mainboard-B.SilkS.gbr, mainboard-Bottom.gbr, mainboard-Edge.Cuts.gbr, mainboard-F.Mask.gbr, mainboard-F.Paste.gbr, mainboard-F.SilkS.gbr]
2020-08-30 fixed WDT part number
    [mainboard.sch]
2020-09-04 bootloader for new mainboard
    [mainboard.kicad_pcb]
2022-02-19 Cleaned schematic, and moved components
    [mainboard.kicad_pcb, mainboard.kicad_sch, mainboard.sch]
2022-02-23 Made suggested changes
    [mainboard.kicad_pcb, mainboard.kicad_sch]
2022-02-23 Updated BOM
2022-02-24 Curved radio trace
    [mainboard.kicad_pcb]
2022-02-27 Moved Rf Antenna. Change J7 to 1x5 Header
    [mainboard.kicad_pcb, mainboard.kicad_sch]
2022-02-27 Expanded inner ground trace
    [mainboard.kicad_pcb]
2022-03-02 Moved RBF Header to under micro USB port
    [mainboard.kicad_pcb, mainboard.kicad_sch, spriteSAMD.kicad_pcb]
2022-03-04 Updated 3D Models
    [mainboard.kicad_pcb, mainboard.kicad_sch, spriteSAMD.kicad_pcb, spriteSAMD.sch]
2022-03-04 Update Kicad-libs
2022-03-04 Assign Radio 3D model
    [mainboard.kicad_pcb]
2022-03-05 Added Step file
    [mainboard.kicad_pcb]
2022-03-12 Replaced Flat flex connector with one in stock + updated step model
    [mainboard.kicad_pcb, mainboard.kicad_sch]
2022-03-13 Changed Flex connector to one from the same family as the one on the solar panels
    [mainboard.kicad_pcb, mainboard.kicad_sch]
2022-03-16 Exported Gerber Files
    [mainboard.kicad_pcb]
2022-05-04 stack outline
    [stack-outline.dxf]
2022-05-09 new mainboard outline
    [mainboard-stack-outline.dxf, stack-outline.dxf]
2022-05-09 Stack Schematic changes
    [BusProtection.kicad_sch, mainboard.kicad_sch]
2022-05-14 Finished v03 routing
    [BusProtection.kicad_sch, mainboard.kicad_pcb, mainboard.kicad_sch]
2022-05-14 Grounded Mounting Holes
    [mainboard-stack-outline.dxf, mainboard.kicad_pcb, mainboard.kicad_sch]
2022-05-16 updated board outline
    [mainboard-outline.dxf]
2022-05-16 Suggested changes
    [mainboard.kicad_pcb, mainboard.kicad_sch]
2022-05-17 Exported Step Model
    [mainboard.kicad_pcb]
2022-05-24 Moved back mounting holes to 3.5mm from board edges
    [mainboard.kicad_pcb]
2022-06-02 added dxf file of mainboard
    [mainboardoutline.dxf]
2022-06-02 Some changes plus new step file
    [mainboard-outline.dxf, mainboard.kicad_pcb, mainboard.kicad_sch]
2022-06-03 Firmware updates for ATSAMD51J19A
    [mainboard.kicad_sch]
2022-06-08 Updated stack connectors and added SPDT switch
    [mainboard.kicad_pcb, mainboard.kicad_sch]
2022-06-08 added pulldown and 0 ohm resistor to VBUS. Renamed VBUS to VUSB
    [mainboard.kicad_pcb, mainboard.kicad_sch]
2022-06-09 Added Logo, version number, and date
    [mainboard.kicad_pcb]
2022-06-10 Exported Gerbers
    [mainboard.kicad_pcb]
2022-06-24 Updated Mainboard-Solar Panels X/Z Connectors
    [mainboard.kicad_pcb, mainboard.kicad_sch]
2022-06-27 Moved Batteryboard connector to avoid solder interference
    [BusProtection.kicad_sch, mainboard.kicad_pcb, mainboard.kicad_sch]
2022-06-29 Recheck board and re-export model
    [mainboard.kicad_pcb, mainboard.kicad_sch]
2022-07-06 Export New Gerbers
    [mainboard.kicad_pcb, mainboard.kicad_sch]
2022-08-11 burnwire pin updates
2022-08-31 Rev A/01 Updates
    [mainboard.kicad_pcb, mainboard.kicad_sch]
2022-08-31 Updated Revision Number to B/03
    [BusProtection.kicad_sch, mainboard.kicad_pcb, mainboard.kicad_sch]
2022-09-02 Repositioned Solar Panel Connectors
    [mainboard.kicad_pcb]
2022-09-02 Added RF cable routing cutout
    [mainboard.kicad_pcb]
2022-09-06 Made BATT_P a Copper Fill
    [BusProtection.kicad_sch, mainboard.kicad_pcb, mainboard.kicad_sch]
2022-09-22 Changes stash
    [BusProtection.kicad_sch, mainboard.kicad_pcb, mainboard.kicad_sch]
2022-09-26 Lots of updates
    [BusProtection.kicad_sch, mainboard.kicad_pcb, mainboard.kicad_sch]
2022-09-27 More updates
    [mainboard.kicad_pcb, mainboard.kicad_sch]
2022-09-28 Finished routing
    [mainboard.kicad_pcb, mainboard.kicad_sch]
2022-09-29 Some fixes
    [BusProtection.kicad_sch, mainboard.kicad_pcb, mainboard.kicad_sch]
2022-09-29 Changed stack connectors to SMD ones
    [mainboard.kicad_pcb, mainboard.kicad_sch]
2022-10-09 Finished B2/01 Updates
    [BusProtection.kicad_sch, mainboard-outline.dxf, mainboard.kicad_pcb, mainboard.kicad_sch, mainboardoutline.dxf]
2022-10-09 Added Pullup to SD CS
    [mainboard.kicad_pcb, mainboard.kicad_sch]
2022-11-09 right-angle reset button + export STEP / BOM
    [mainboard.kicad_pcb, mainboard.kicad_sch]
2022-11-11 DFM Updates
    [mainboard.kicad_pcb]
2022-11-11 Export Gerbers
    [mainboard.kicad_pcb]
2023-02-18 Stash before major changes
    [BusProtection.kicad_sch, mainboard.kicad_pcb, mainboard.kicad_sch]
2023-02-18 Finished routing Rev B3/01
    [BusProtection.kicad_sch, mainboard.kicad_pcb, mainboard.kicad_sch]
2023-02-18 Updated Schematic to reflect RTC on I2C 1
    [BusProtection.kicad_sch, mainboard.kicad_sch]
2023-02-19 Minor updates
    [mainboard.kicad_pcb, mainboard.kicad_sch]
2023-02-25 Moved Neopixel to be visible through X board hole
    [BusProtection.kicad_sch, mainboard.kicad_pcb]
2023-02-26 Removed gerbers from repo
2023-04-26 Rev B3/02 Updates
    [BusProtection.kicad_sch, mainboard.kicad_pcb, mainboard.kicad_sch]
2023-04-26 Leftover updates
    [mainboard.kicad_pcb]
2023-06-18 Re-wired IMU to use UART
    [BusProtection.kicad_sch, mainboard.kicad_pcb, mainboard.kicad_sch]
2023-06-19 Moved Rev label to be visible post-assembly
    [BusProtection.kicad_sch, mainboard.kicad_pcb, mainboard.kicad_sch]
2023-06-19 Pull kicad-libs
2023-06-20 PCB cleanup
    [mainboard.kicad_pcb]
